Skh4rf/HTLRIOT-OpenMV/README.md

# HTLRIOT-OpenMV
  
This project shows the implementation of a position detection using the OpenMV-Cameras.

## Documentation
See more in our [documentation](https://github.com/Skh4rf/HTLRIOT-OpenMV/blob/main/doc/Cibulka_Metzler_Projekt_OpenMV_Positionserfassung.pdf)
