Skh4rf/HTLRIOT-OpenMV/hw/Haltegeruest/alt_Gesamtaufbau.SLDASM

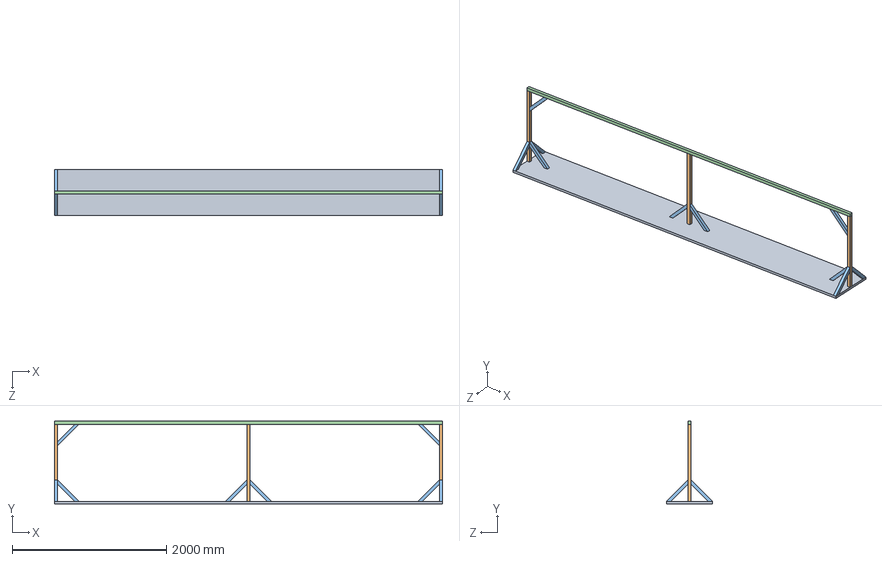
[picture p17: CAD file, 2023-02-01]
hw/Haltegeruest/alt_Gesamtaufbau.SLDASM
5035.0 x 1071.0 x 600.0 mm
Grundplatte
Steher x 3
Quersteher x 10
Querbalken
