Skh4rf/HTLRIOT-OpenMV/hw/Haltegeruest/Mittelsteher.SLDASM

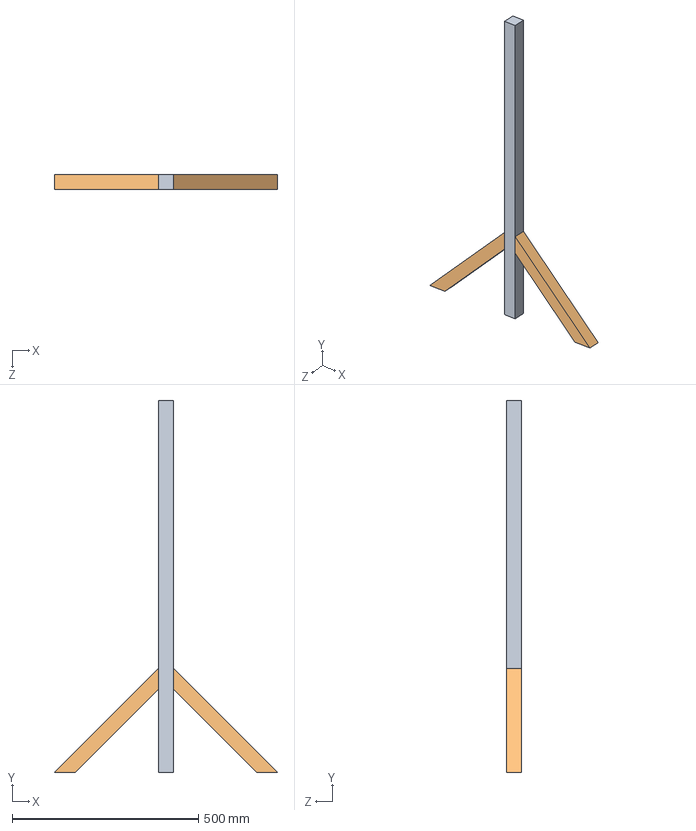
[picture p18: CAD file, 2023-02-01]
hw/Haltegeruest/Mittelsteher.SLDASM
600.0 x 1000.0 x 40.0 mm
Steher
Quersteher x 2
