Skh4rf/HTLRIOT-OpenMV/hw/Haltegeruest/Seitensteher.SLDASM

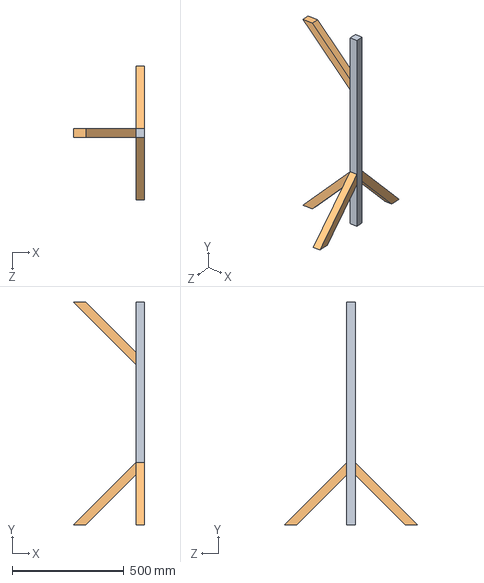
[picture p19: CAD file, 2023-02-01]
hw/Haltegeruest/Seitensteher.SLDASM
320.0 x 1000.0 x 600.0 mm
Steher
Quersteher x 4
