Skh4rf/HTLRIOT-OpenMV/hw/Haltegeruest/Gesamtaufbau.SLDASM

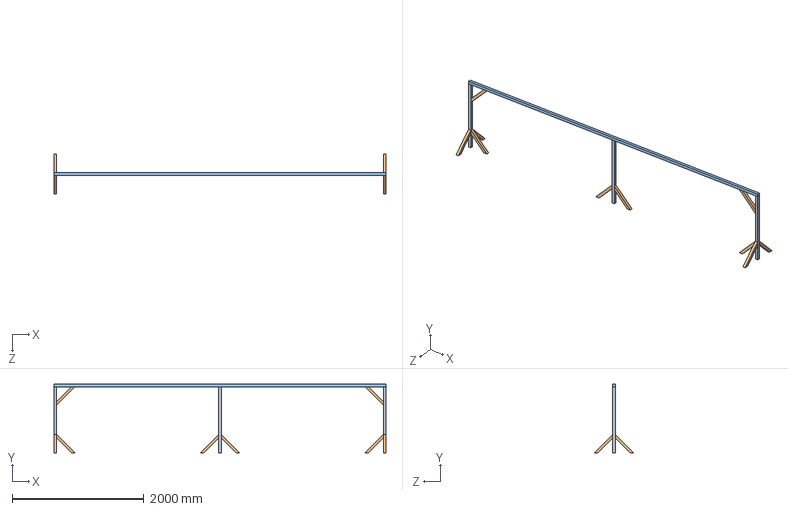
[picture p20: CAD file, 2023-02-01]
hw/Haltegeruest/Gesamtaufbau.SLDASM
5035.0 x 1040.0 x 600.0 mm
Steher x 3
Quersteher x 10
Querbalken
