Skh4rf/HTLRIOT-OpenMV/hw/Befestigungsclip/halter.SLDPRT

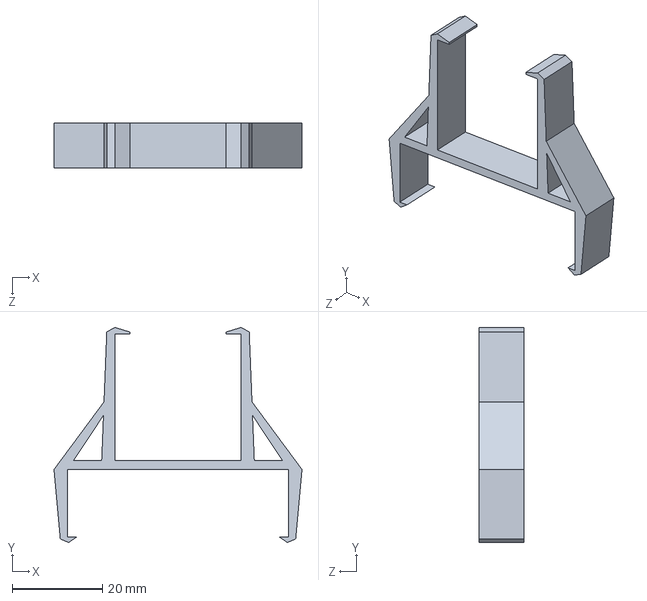
[picture p21: CAD file, 2023-02-01]
hw/Befestigungsclip/halter.SLDPRT
55.0 x 47.7 x 10.0 mm
