Skh4rf/HTLRIOT-OpenMV/hw/Haltegeruest/Grundplatte.SLDPRT

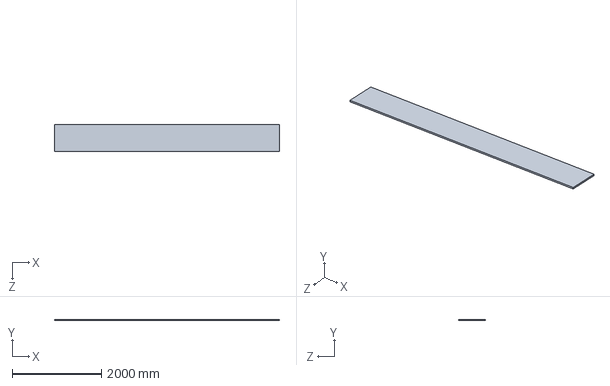
[picture p22: CAD file, 2023-02-01]
hw/Haltegeruest/Grundplatte.SLDPRT
5035.0 x 31.0 x 600.0 mm
