Skh4rf/HTLRIOT-OpenMV/hw/Haltegeruest/Querbalken.SLDPRT

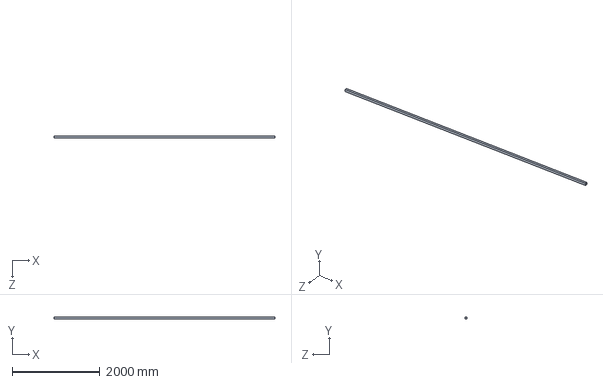
[picture p23: CAD file, 2023-02-01]
hw/Haltegeruest/Querbalken.SLDPRT
5035.0 x 40.0 x 40.0 mm
