Skh4rf/HTLRIOT-OpenMV/hw/Haltegeruest/Quersteher.SLDPRT

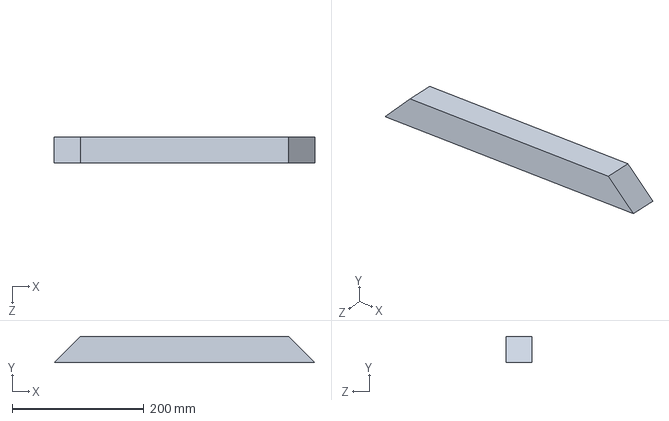
[picture p24: CAD file, 2023-02-01]
hw/Haltegeruest/Quersteher.SLDPRT
396.0 x 40.0 x 40.0 mm
