Skh4rf/HTLRIOT-OpenMV/hw/Haltegeruest/Steher.SLDPRT

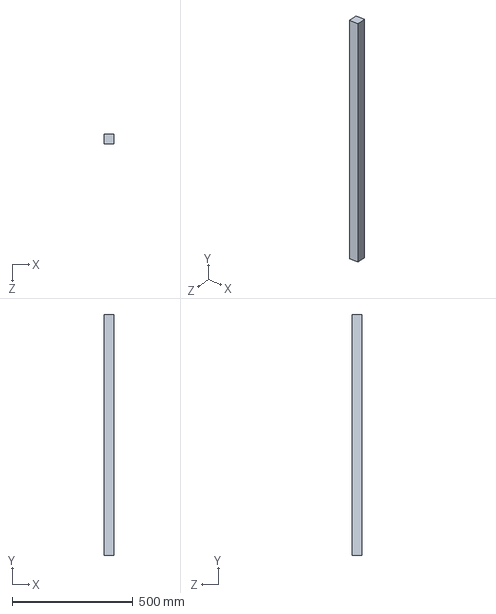
[picture p25: CAD file, 2023-02-01]
hw/Haltegeruest/Steher.SLDPRT
40.0 x 1000.0 x 40.0 mm
