Skh4rf/HTLRIOT-OpenMV/(list of files, cad)

Other CAD files:
hw/Befestigungsclip/halter.SLDDRW
hw/Befestigungsclip/halter.STL
hw/Haltegeruest/Gesamtaufbau.SLDDRW
hw/Haltegeruest/Mittelsteher.SLDDRW
hw/Haltegeruest/Querbalken.SLDDRW
hw/Haltegeruest/Quersteher.SLDDRW
hw/Haltegeruest/Seitensteher.SLDDRW
hw/Haltegeruest/Steher.SLDDRW
