Skh4rf/HTLRIOT-OpenMV/hw/HTLRIOT_ZugDemo_Haltegeruest.pdf

2

POS-NR. | BENENNUNG | MENGE

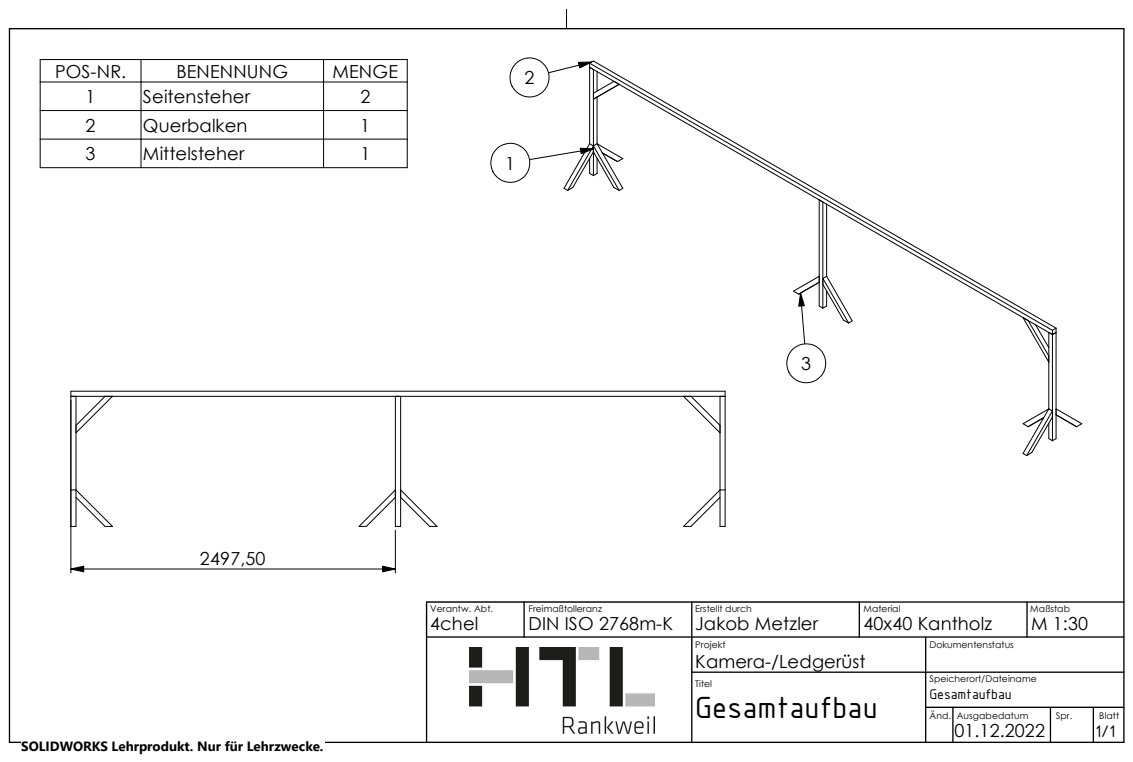
[picture p26: page 1]

1 | Seitensteher | 2
2 | Querbalken | 1
3 | Mittelsteher | 1

Verantw. Abt. 4chel | Freimaßtolleranz DIN ISO 2768m-K | Erstellt durch Jakob Metzler | Material 40x40 Kantholz | Maßstab M 1:30

Projekt Kamera-/Ledgerüst | Dokumentenstatus
Titel Gesamtaufbau | Speicherort/Dateiname Gesamtaufbau

Änd. | 01.12.2022 | Spr. | Blatt Ausgabedatum 1/1

SOLIDWORKS Lehrprodukt. Nur für Lehrzwecke.

POS-NR. | BENENNUNG | MENGE
1 | Steher | 1

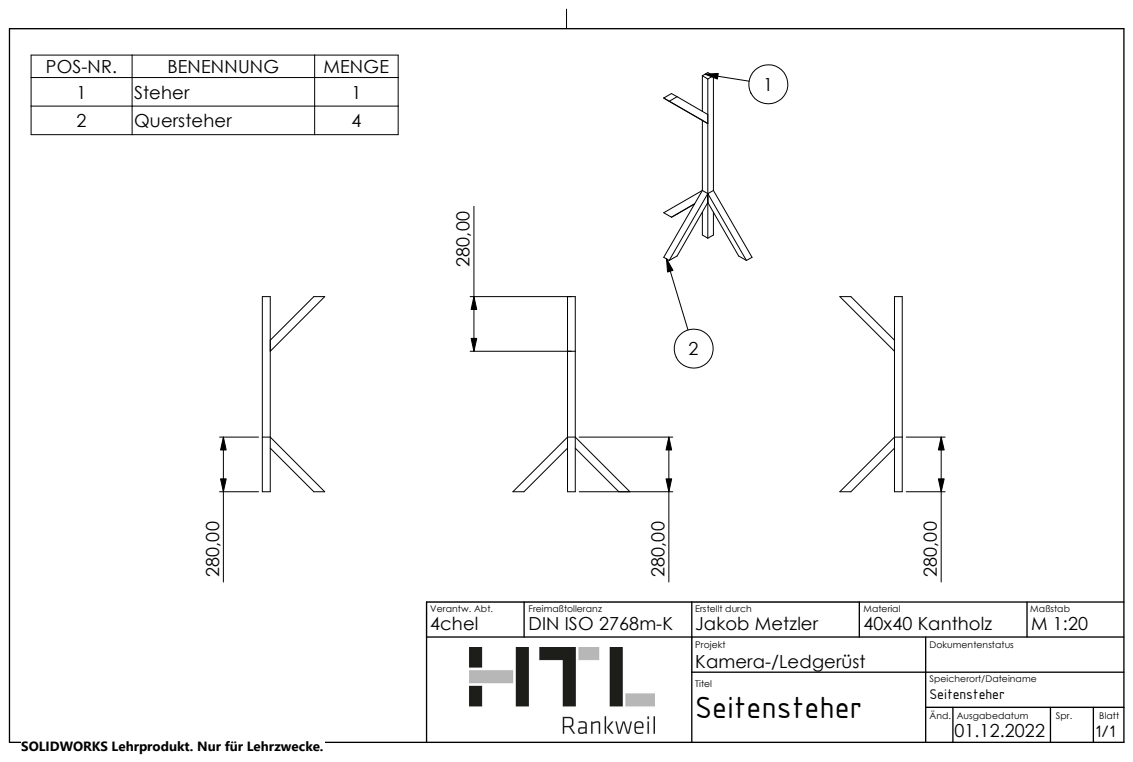
[picture p27: page 2]
Seitensteher; Änd.; Spr.; Blatt Ausgabedatum; M 1:20 ²⁸⁰,00 280,00; Quersteher

Verantw. Abt. 4chel | Freimaßtolleranz DIN ISO 2768m-K | Erstellt durch Jakob Metzler | Material 40x40 Kantholz | Maßstab

Projekt Kamera-/Ledgerüst | Dokumentenstatus

Titel | Speicherort/Dateiname Seitensteher

1

POS-NR. | BENENNUNG | MENGE

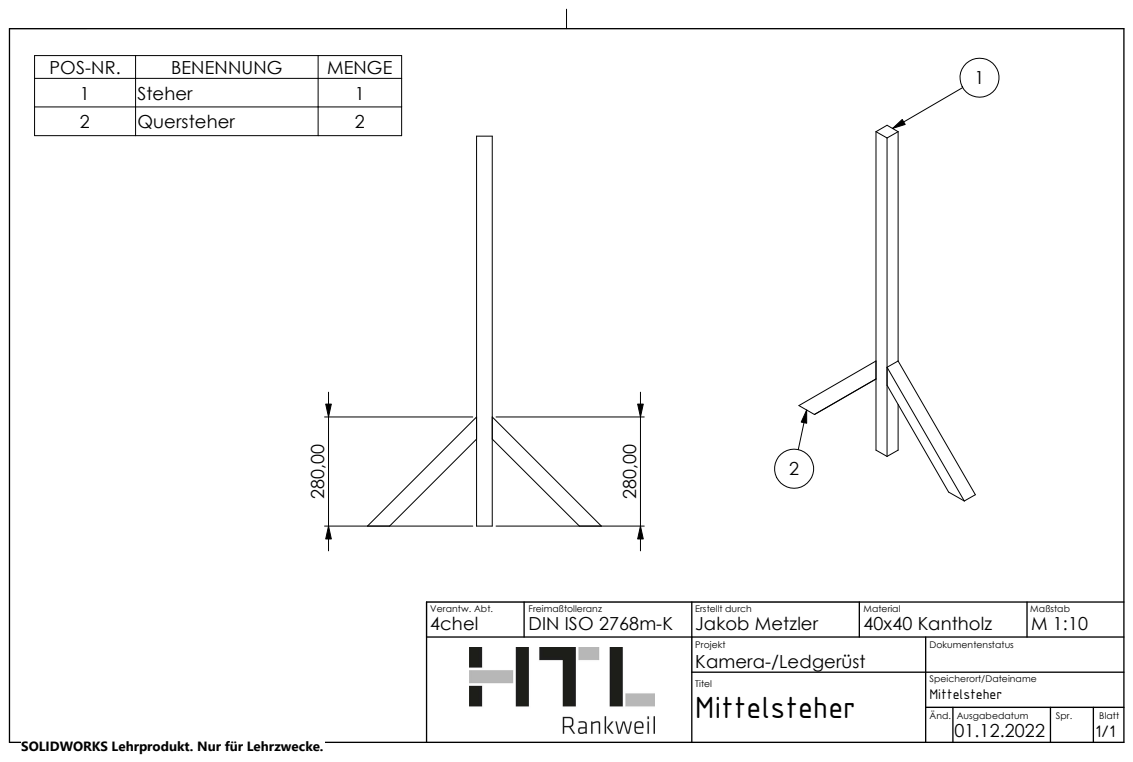
[picture p28: page 3]
Mittelsteher; Änd.; Spr.; Blatt Ausgabedatum; Quersteher

1 | Steher | 1

Verantw. Abt. 4chel | Freimaßtolleranz DIN ISO 2768m-K | Erstellt durch Jakob Metzler | Material 40x40 Kantholz | Maßstab M 1:10

Projekt Kamera-/Ledgerüst | Dokumentenstatus
Titel | Speicherort/Dateiname Mittelsteher

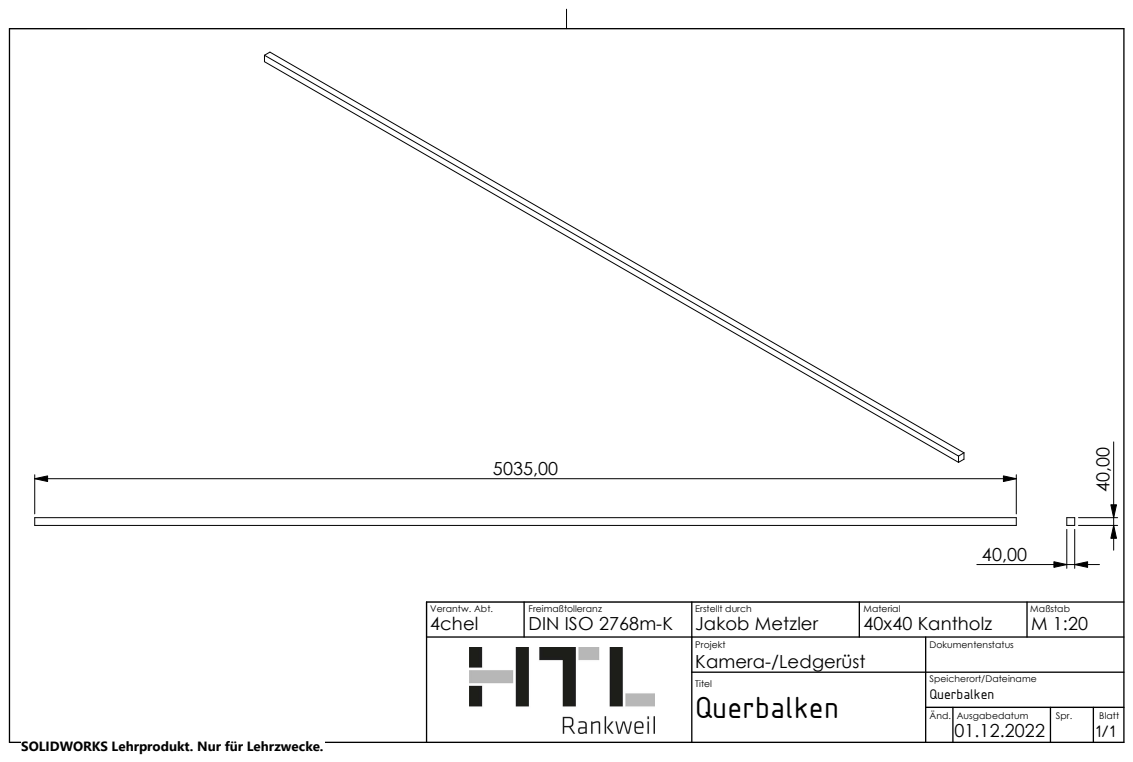
[picture p29: page 4]

Verantw. Abt. 4chel | Freimaßtolleranz DIN ISO 2768m-K | Erstellt durch Jakob Metzler | Material 40x40 Kantholz | Maßstab M 1:20

Projekt Kamera-/Ledgerüst | Dokumentenstatus

Titel Querbalken | Speicherort/Dateiname Querbalken

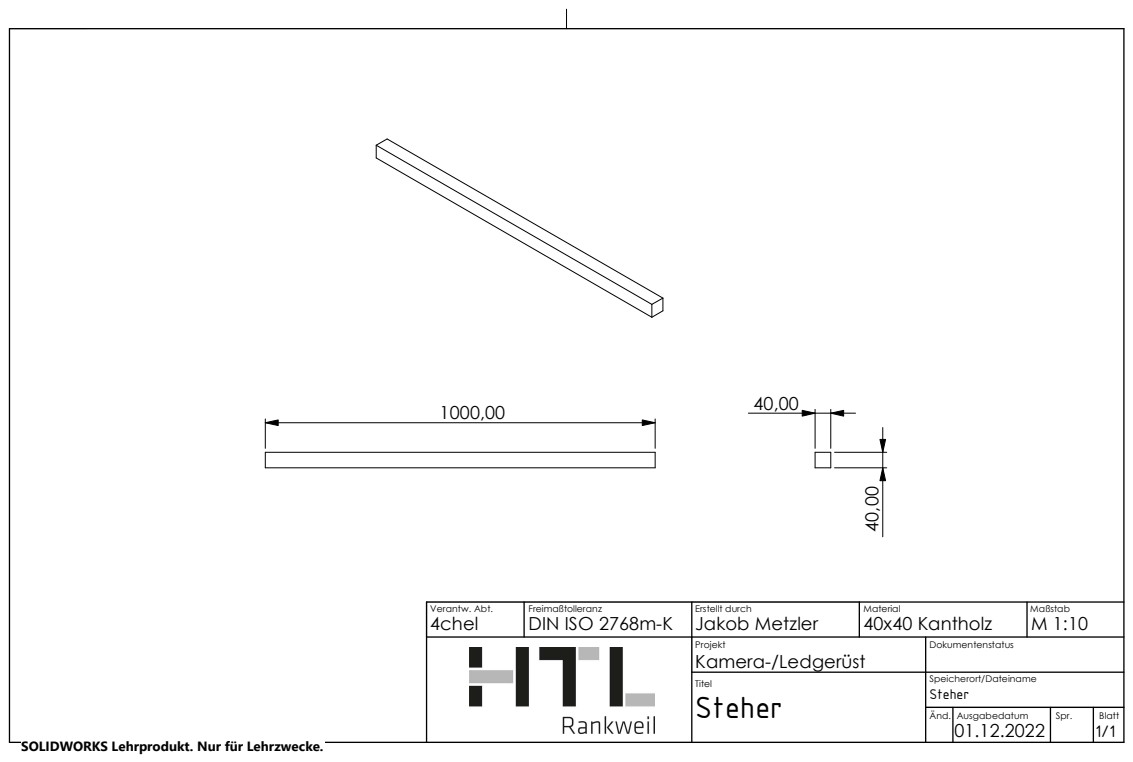
[picture p30: page 5]
Steher; Änd.; Spr.; Blatt Ausgabedatum

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

Projekt Kamera-/Ledgerüst | Dokumentenstatus
Titel | Speicherort/Dateiname Steher

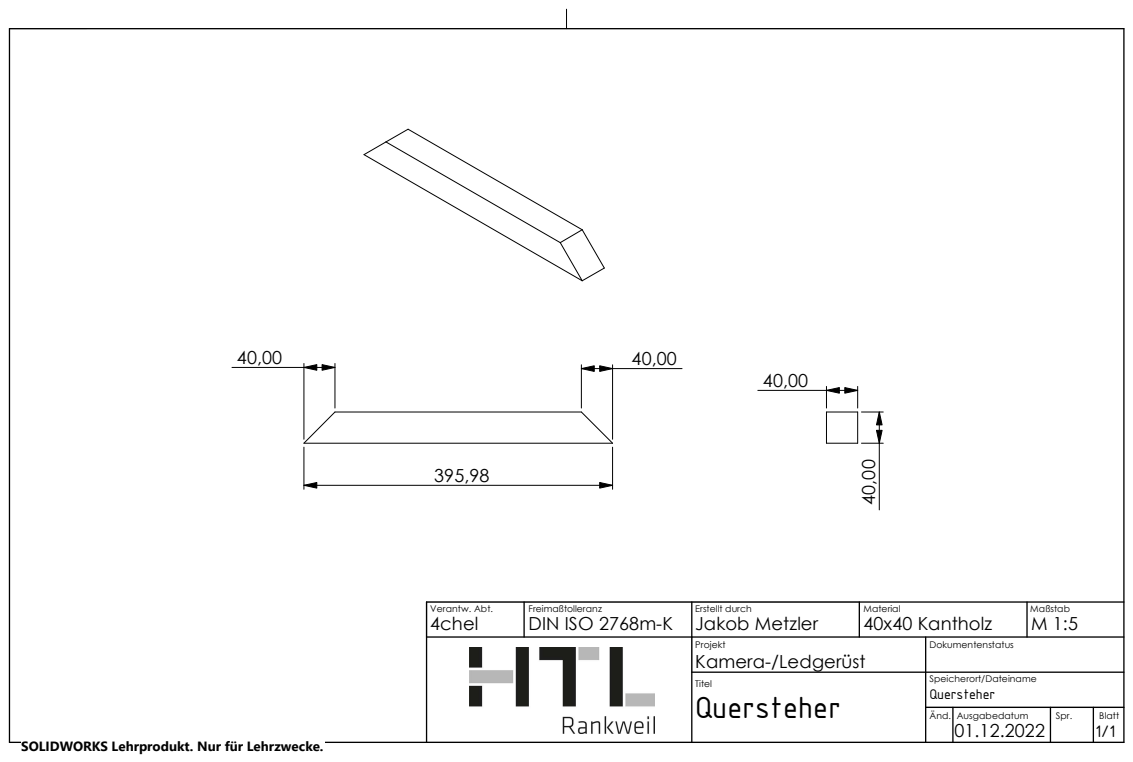
[picture p31: page 6]

Verantw. Abt. 4chel | Freimaßtolleranz DIN ISO 2768m-K | Erstellt durch Jakob Metzler | Material 40x40 Kantholz | Maßstab M 1:5

Projekt Kamera-/Ledgerüst | Dokumentenstatus

Titel Quersteher | Speicherort/Dateiname Quersteher
