Skh4rf/HTLRIOT-OpenMV/hw/HTLRIOT_OpenMV_Befestigungsclip.pdf

E E

F F

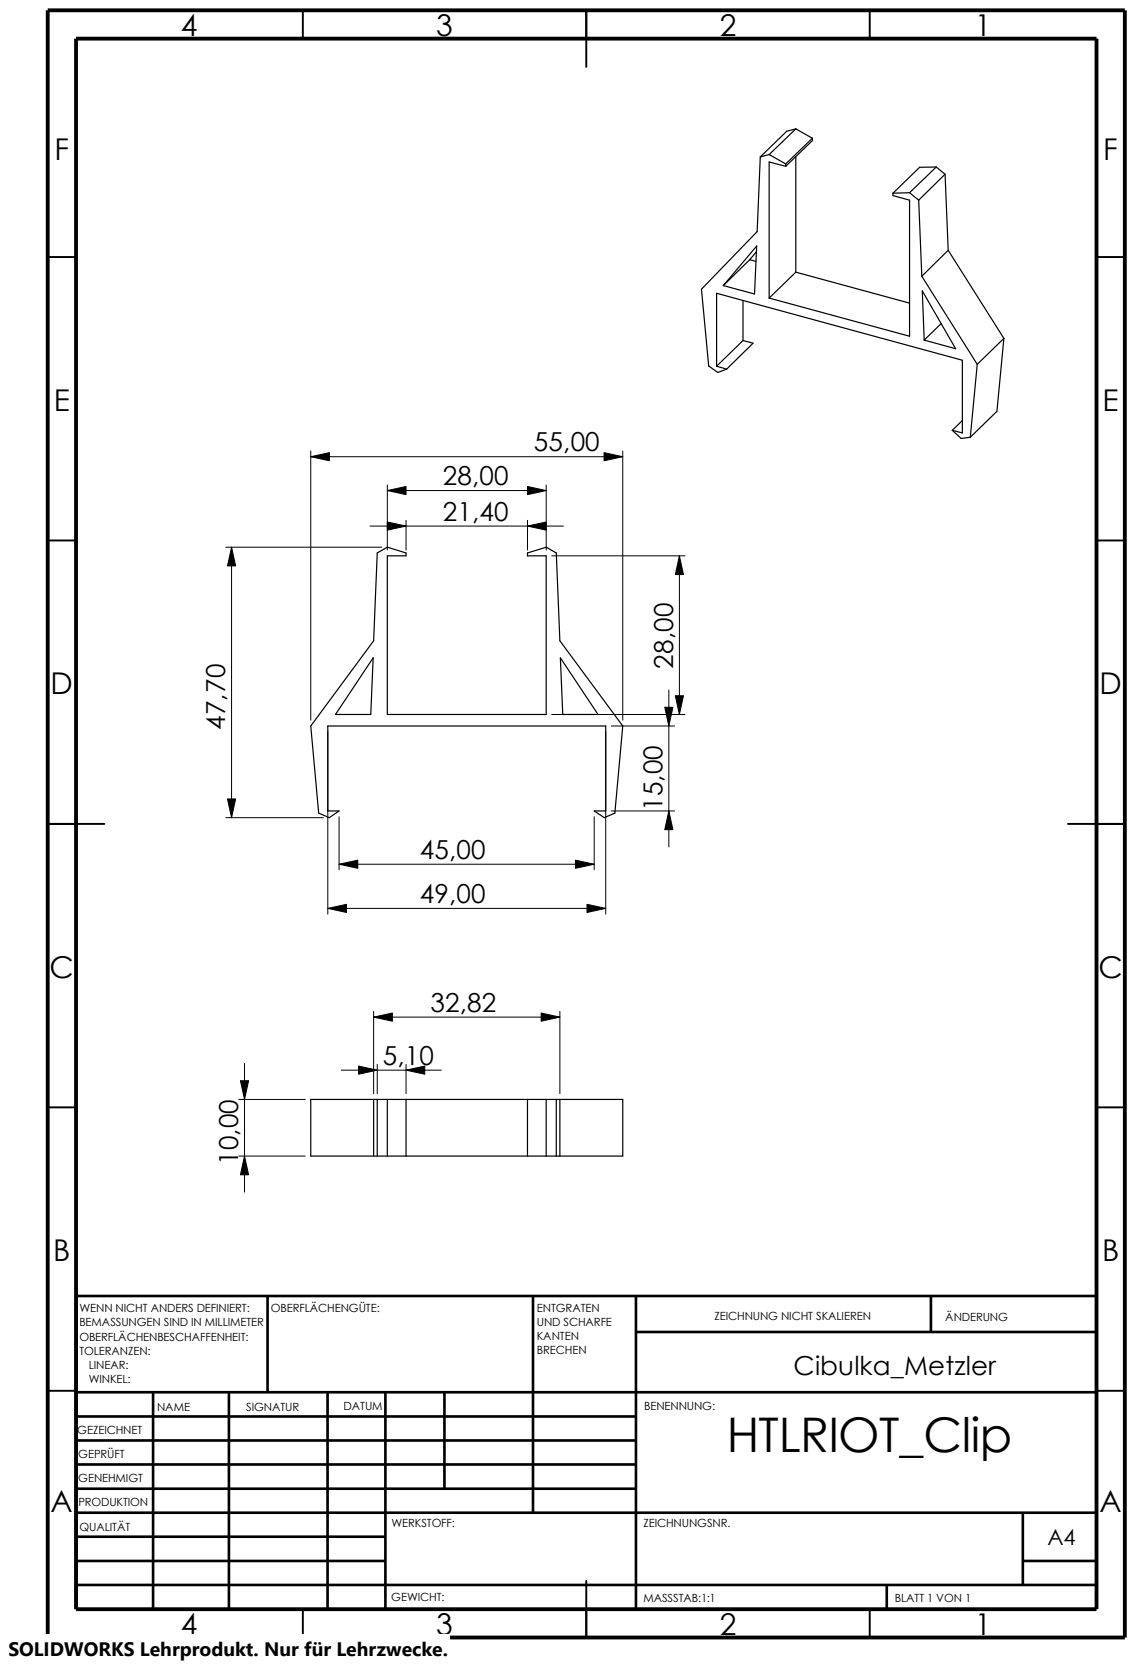
[picture p32: page 1]
QUALITÄT; PRODUKTION; GEWICHT:; BLATT 1 VON 1MASSSTAB:1:1; ZEICHNUNGSNR.; ZEICHNUNG NICHT SKALIEREN; ÄNDERUNG; OBERFLÄCHENGÜTE:; BRECHEN; ENTGRATEN; WERKSTOFF:; UND SCHARFE KANTEN; LINEAR:; Cibulka_Metzler

WENN NICHT ANDERS DEFINIERT:
BEMASSUNGEN SIND IN MILLIMETER
OBERFLÄCHENBESCHAFFENHEIT:
TOLERANZEN:
WINKEL:

NAME | SIGNATUR | DATUM | BENENNUNG: HTLRIOT_Clip

GEZEICHNET

GEPRÜFT

GENEHMIGT

SOLIDWORKS Lehrprodukt. Nur für Lehrzwecke.
